rileyhill625/current-injection-test-set/Current_injection_verification.png

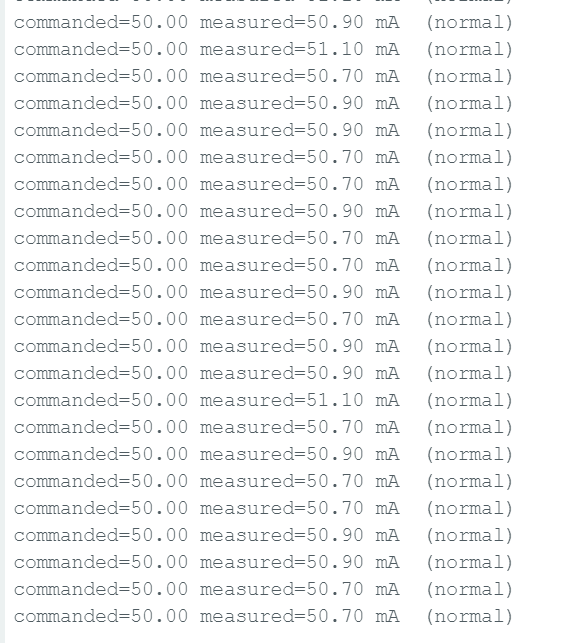
Current_injection_verification.png
