rileyhill625/current-injection-test-set/(commit log)

2026-07-31 add INA219 sensor test
2026-08-28 complete documentation of current injection test set
