rileyhill625/current-injection-test-set/Current_injection_relay.jpg

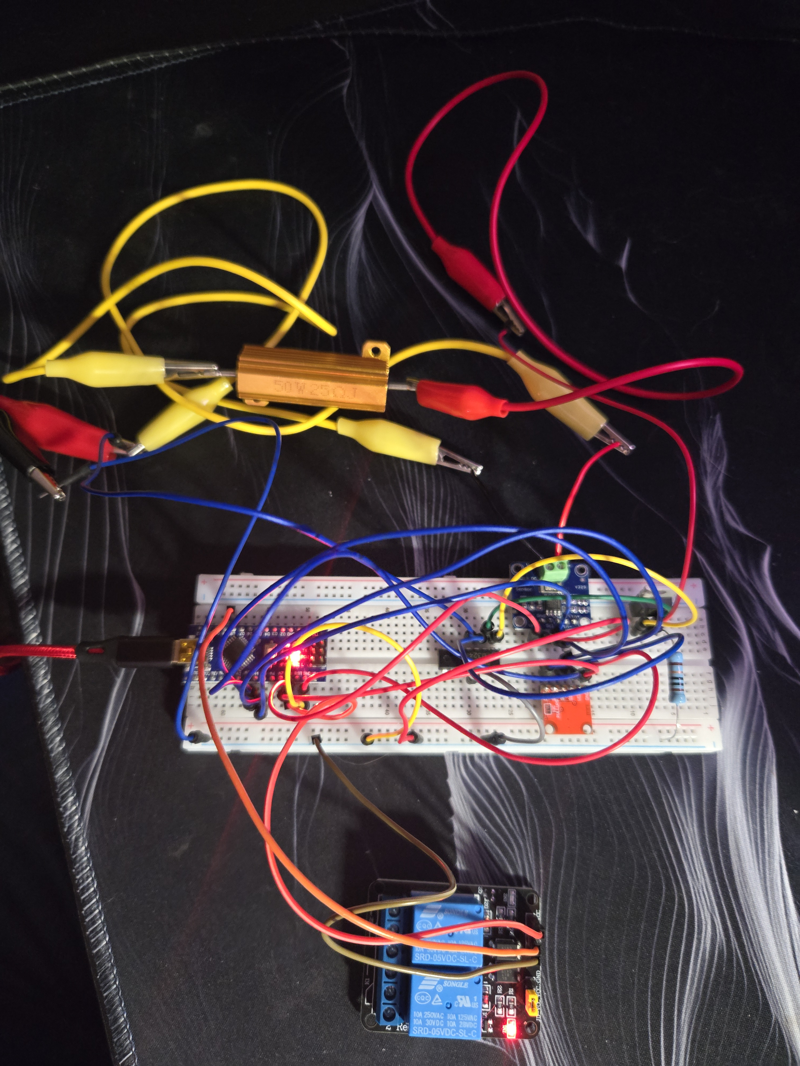
Current_injection_relay.jpg
